libc0607/3516AIO/BOM_3516aio_3516aio_v1p1_2024-05-15.xlsx

No. | Quantity | Comment | Designator | Footprint | Value | Manufacturer Part | Manufacturer | Supplier Part | Supplier
1 | 5 | 10uF | C1,C20,C168,C174,C176 | 0402 | 10uF | CC0402KRX7R7BB104 | YAGEO(国巨) | C15195 | LCSC
2 | 4 | 2.2uF | C2,C3,C5,C14 | 0402 | 2.2uF | CC0402KRX7R7BB104 | YAGEO(国巨) | C15195 | LCSC
3 | 22 | 100nF | C6,C7,C8,C9,C10,C11,C12,C13,C15,C17,C19,C21,C23,C71,C191,C192,C193,C194,C195,C196,C209,C211 | 0402 | 100nF | CC0402KRX7R7BB104 | YAGEO(国巨) | C15195 | LCSC
4 | 2 | 220nF | C83,C155 | 0402 |  | CL05B224KO5NNNC | SAMSUNG | C15195 | LCSC
5 | 3 | 1uF | C84,C85,C86 | 0402 |  | CL05A105KA5NQNC | SAMSUNG | C15195 | LCSC
6 | 13 | 4.7uF | C93,C134,C136,C138,C140,C148,C157,C159,C164,C165,C167,C169,C170 | 0402 |  | CL05A475MP5NRNC | SAMSUNG | C15195 | LCSC
7 | 1 | 18pF | C118 | 0402 |  | 0402CG180J500NT | FH | C15195 | LCSC
8 | 12 | 10nF | C120,C161,C172,C173,C175,C212,C213,C214,C215,C216,C217,C218 | 0402 |  | CL05B103KB5NNNC | SAMSUNG | C15195 | LCSC
9 | 5 | 100nF | C126,C156,C158,C163,C166 | 0402 |  | CL05B104KO5NNNC | SAMSUNG | C15195 | LCSC
10 | 6 | 22uF | C160,C183,C184,C206,C207,C208 | 0805 | 22uF | CL21A226MAQNNNE | SAMSUNG(三星) | C2838369 | LCSC
11 | 2 | 18pF | C177,C178 | 0402 | 18pF | 0402CG180J500NT | FH(风华) | C15195 | LCSC
12 | 2 | 22uF | C200,C202 | 0603 | 22uF | CL10A226MQ8NRNC | SAMSUNG(三星) | C72038 | LCSC
13 | 1 | 100nF/NC | C210 | 0402 | 100nF/NC | CC0402KRX7R7BB104 | YAGEO(国巨) |  | LCSC
14 | 1 | PESD12VL1BA-N | D2 | SOD-323_L1.8-W1.3-LS2.5-BI |  | PESD12VL1BA-N | BORN(伯恩半导体) | C314261 | LCSC
15 | 1 | BSMD0805-075-12V | F2 | F0805 |  | BSMD0805-075-12V | BHFUSE(佰宏) | C883111 | LCSC
16 | 1 | PM127V-12-08-H43 | H1 | HDR-TH_8P-P1.27-V-F-R2-C4-S1.27 |  | PM127V-12-08-H43 | XFCN(兴飞) | C509139 | LCSC
17 | 4 | BLM15HG102SN1D | L1,L2,L3,L4 | 0402 |  | BLM15HG102SN1D | muRata(村田) | C15195 | LCSC
18 | 2 | 2.2uH | L7,L8 | 0805 | 2.2uH
19 | 1 | KT-0603R | LED1 | 0603 |  | KT-0603R | KENTO | C72038 | LCSC
20 | 1 | 19-213/Y2C-CQ2R2L/3T(CY) | LED2 | 0603 |  | 19-213/Y2C-CQ2R2L/3T(CY) | EVERLIGHT(亿光) | C72038 | LCSC
21 | 7 | 4.7kΩ | R23,R25,R27,R29,R32,R807,R808 | 0402 | 4.7kΩ | 0402WGF4701TCE | UNI-ROYAL(厚声) | C25900 | LCSC
22 | 1 | 10kΩ | R30 | 0402 | 10kΩ | 0402WGF1002TCE | UNI-ROYAL(厚声) | C15195 | LCSC
23 | 3 | 4.7kΩ | R33,R34,R35 | 0402 | 4.7kΩ | 0402WGF4701TCE | UNI-ROYAL(厚声) | C15195 | LCSC
24 | 1 | 1.5kΩ | R65 | 0402 | 1.5kΩ | 0402WGF1002TCE | UNI-ROYAL(厚声) | C15195 | LCSC
25 | 1 | 41.2K | R74 | 0402 |  | 0402WGF4122TCE | UniOhm | C15195 | LCSC
26 | 1 | 30.1K | R75 | 0402 |  | 0402WGF3012TCE | UniOhm | C15195 | LCSC
27 | 2 | 15kΩ | R809,R820 | 0402 | 15kΩ | 0402WGF1502TCE | UNI-ROYAL(厚声) | C15195 | LCSC
28 | 1 | 47kΩ | R810 | 0402 | 47kΩ | 0402WGF4702TCE | UNI-ROYAL(厚声) | C15195 | LCSC
29 | 1 | 51kΩ | R811 | 0402 | 51kΩ | 0402WGF5102TCE | UNI-ROYAL(厚声) | C15195 | LCSC
30 | 4 | 100kΩ | R812,R814,R821,R832 | 0402 | 100kΩ | 0402WGF1003TCE | UNI-ROYAL(厚声) | C15195 | LCSC
31 | 1 | 200kΩ | R815 | 0402 | 200kΩ | 0402WGF2003TCE | UNI-ROYAL(厚声) | C15195 | LCSC
32 | 5 | 49.9Ω | R816,R817,R818,R819,R835 | 0402 | 49.9Ω | 0402WGF499JTCE | UNI-ROYAL(厚声) | C15195 | LCSC
33 | 4 | 1kΩ | R822,R823,R833,R834 | 0402 | 1kΩ | 0402WGF1001TCE | UNI-ROYAL(厚声) | C15195 | LCSC
34 | 2 | 1kΩ/NC | R824,R825 | 0402 | 1kΩ/NC | 0402WGF1001TCE | UNI-ROYAL(厚声) |  | LCSC
35 | 6 | 4.7kΩ/NC | R826,R827,R828,R829,R830,R831 | 0402 | 4.7kΩ/NC | 0402WGF4701TCE | UNI-ROYAL(厚声) |  | LCSC
36 | 1 | Hi3516EV200 | U1 | QFN-88 L9.0-W9.0-P0.35-BL-EP5.26 |  |  |  | C2802265
37 | 1 | W25Q128JVSIQ | U2 | SOIC-8_L5.3-W5.3-P1.27-LS8.0-BL |  | W25Q128JVSIQ | WINBOND(华邦) | C97521 | LCSC
38 | 1 | IMX307LQD-C | U3 | IMX307LQD-C__NO_IRCUT |  |  |  | C2940553
39 | 1 | BL-M8731BU4 | U11 | BL-M8731BU4 |  |  |  | C19184601
40 | 1 | TPS82130SILR | U12 | USIP-8_L3.0-W2.8-P0.65-TL-EP |  | TPS82130SILR | TI(德州仪器) | C473914 | LCSC
41 | 1 | TPS79301DBVR | U13 | SOT-23-6_L2.9-W1.6-P0.95-LS2.8-BR |  | TPS79301DBVR | TI(德州仪器) | C37151 | LCSC
42 | 2 | SY8088AAC | U14,U15 | SOT-23-5_L3.0-W1.7-P0.95-LS2.8-BR |  | SY8088AAC | silergy(矽力杰) | C79313 | LCSC
43 | 1 | ZX-PM1.27-2-5PU | U16 | HDR-TH_10P-P1.27-V-F-R2-C5-S1.27 |  | ZX-PM1.27-2-5PU | Megastar(兆星) | C7499360 | LCSC
44 | 1 | 2343U-108CNG1SNT01 | U17 | HDR-TH_8P-P1.27-V-F |  | 2343U-108CNG1SNT01 | 华宇创 | C350285 | LCSC
45 | 1 | XC6206P122MR(1uA) | U18 | SOT-23-3_L2.9-W1.6-P1.90-LS2.8-BR |  | XC6206P122MR(1uA) | TECH PUBLIC(台舟) | C2827649 | LCSC
46 | 1 | 24MHz | X11 | CRYSTAL-SMD_4P-L2.0-W1.6-BL | 24MHz | XL7EL89CMI-111YLC-24M | YXC(扬兴晶振) | C2965581 | LCSC
