libc0607/3516AIO/SCH_3516aio_v1p1_2024-05-15.pdf

# To Ext. Board

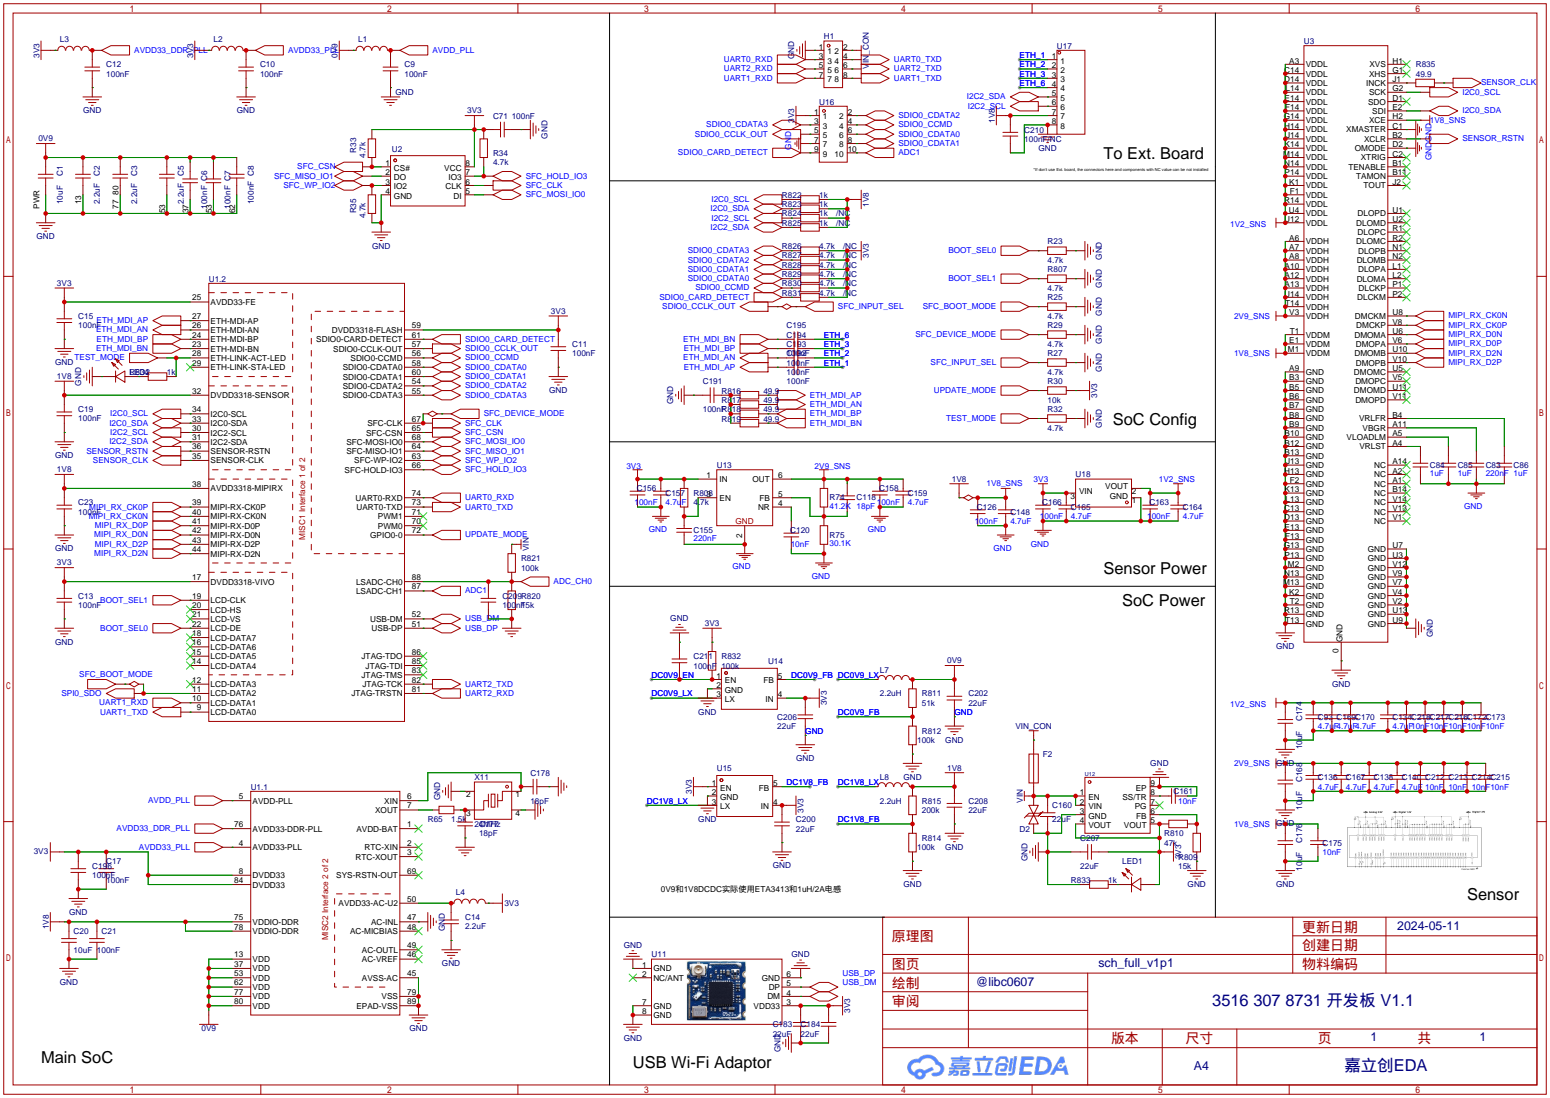
[picture p1: page 1]

*If don't use Ext. board, the connectors here and components with NC value can be not installed

AVDD33-FE 25
ETH-MDI-AP 27
ETH-MDI-AN 26
ETH-MDI-BP 24
ETH-MDI-BN 23
ETH-LINK-STA-LED 29 ETH-LINK-ACT-LED 28

SFC-CLK 67
SFC-CSN 65
SFC-MOSI-IO0 68
SFC-WP-IO2 63 SFC-MISO-IO1 64
SFC-HOLD-IO3 66

AVDD3318-MIPIRX 38
MIPI-RX-D2N 44 MIPI-RX-D2P 43 MIPI-RX-D0N 42 MIPI-RX-D0P 41 MIPI-RX-CK0N 40 MIPI-RX-CK0P 39

DVDD3318-VIVO 17
LCD-DE 22 LCD-VS 21 LCD-HS 20 LCD-CLK 19

USB-DP 51 USB-DM 52

JTAG-TRSTN 81 JTAG-TCK 82 JTAG-TMS 83 JTAG-TDI 85 JTAG-TDO 86
