libc0607/3516AIO/(list of files, drawings)

Other design files:
ProProject_3516_307_8731_devboard_V1.1_2024-05-14.epro
